FJLabs-Designs/carbon-fiber-plates/cad_files/2U Shift - Fillet.dxf

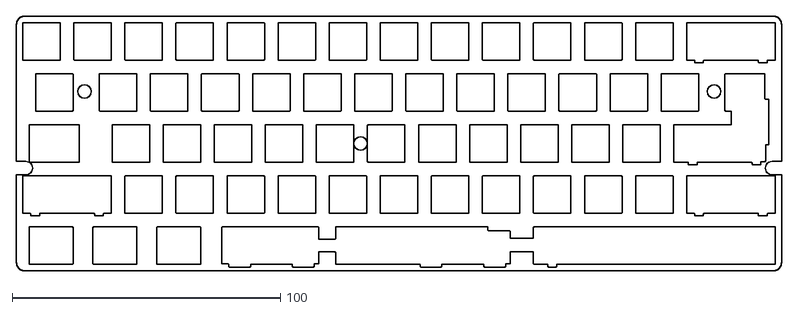
[picture p1: CAD file, 2020-08-20]
cad_files/2U Shift - Fillet.dxf
285.4 x 94.9
